2pair/preample/power/power.kicad_pcb

## KiCad design power/power.kicad_pcb (2019-06-02)

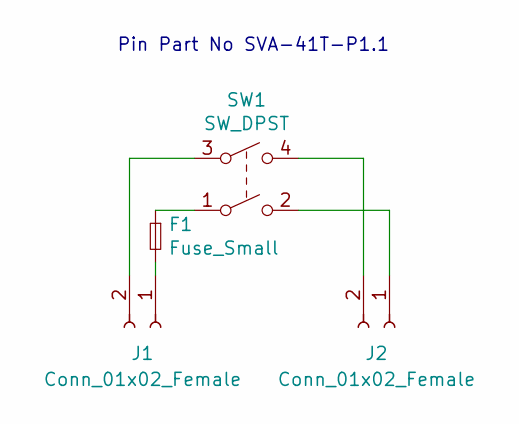
[picture p1: schematic power.sch]

Parts:
F1: Fuse_Small; Keystone 4628 Fuse Holder
J1, J2: Conn_01x02_Female; B2P3-VH
SW1: SW_DPST; E-Switch_P227EE1CXC

Connections:
unnamed: F1.1, SW1.1
unnamed: F1.2, J1.1
unnamed: J1.2, SW1.3
unnamed: J2.1, SW1.2
unnamed: J2.2, SW1.4

Notes on the sheet:
Pin Part No SVA-41T-P1.1

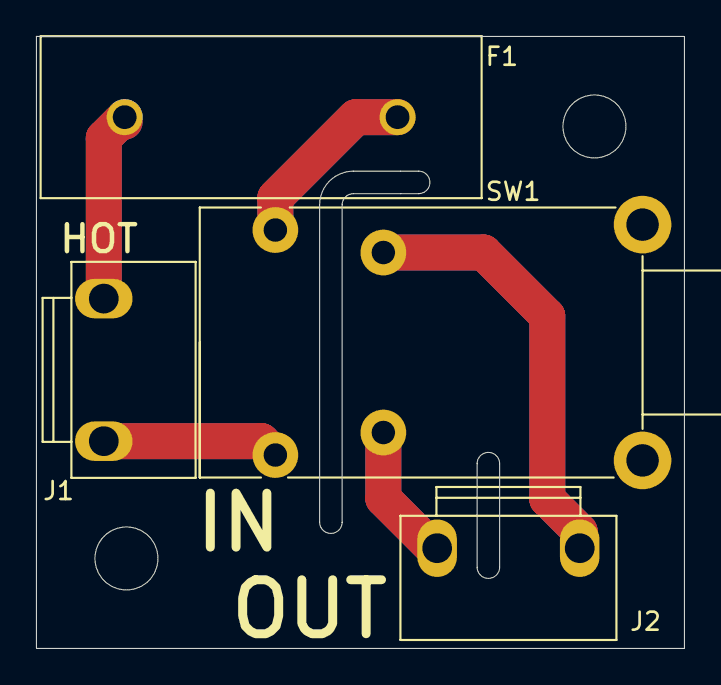
[picture p2: board power.kicad_pcb from above]

Board: 2 copper layers, 36.0 x 34.0 mm, 4 parts (0 on the bottom side), 5 nets.
