2pair/preample/preample/preample.kicad_pcb

## KiCad design preample/preample.kicad_pcb (2019-06-02)

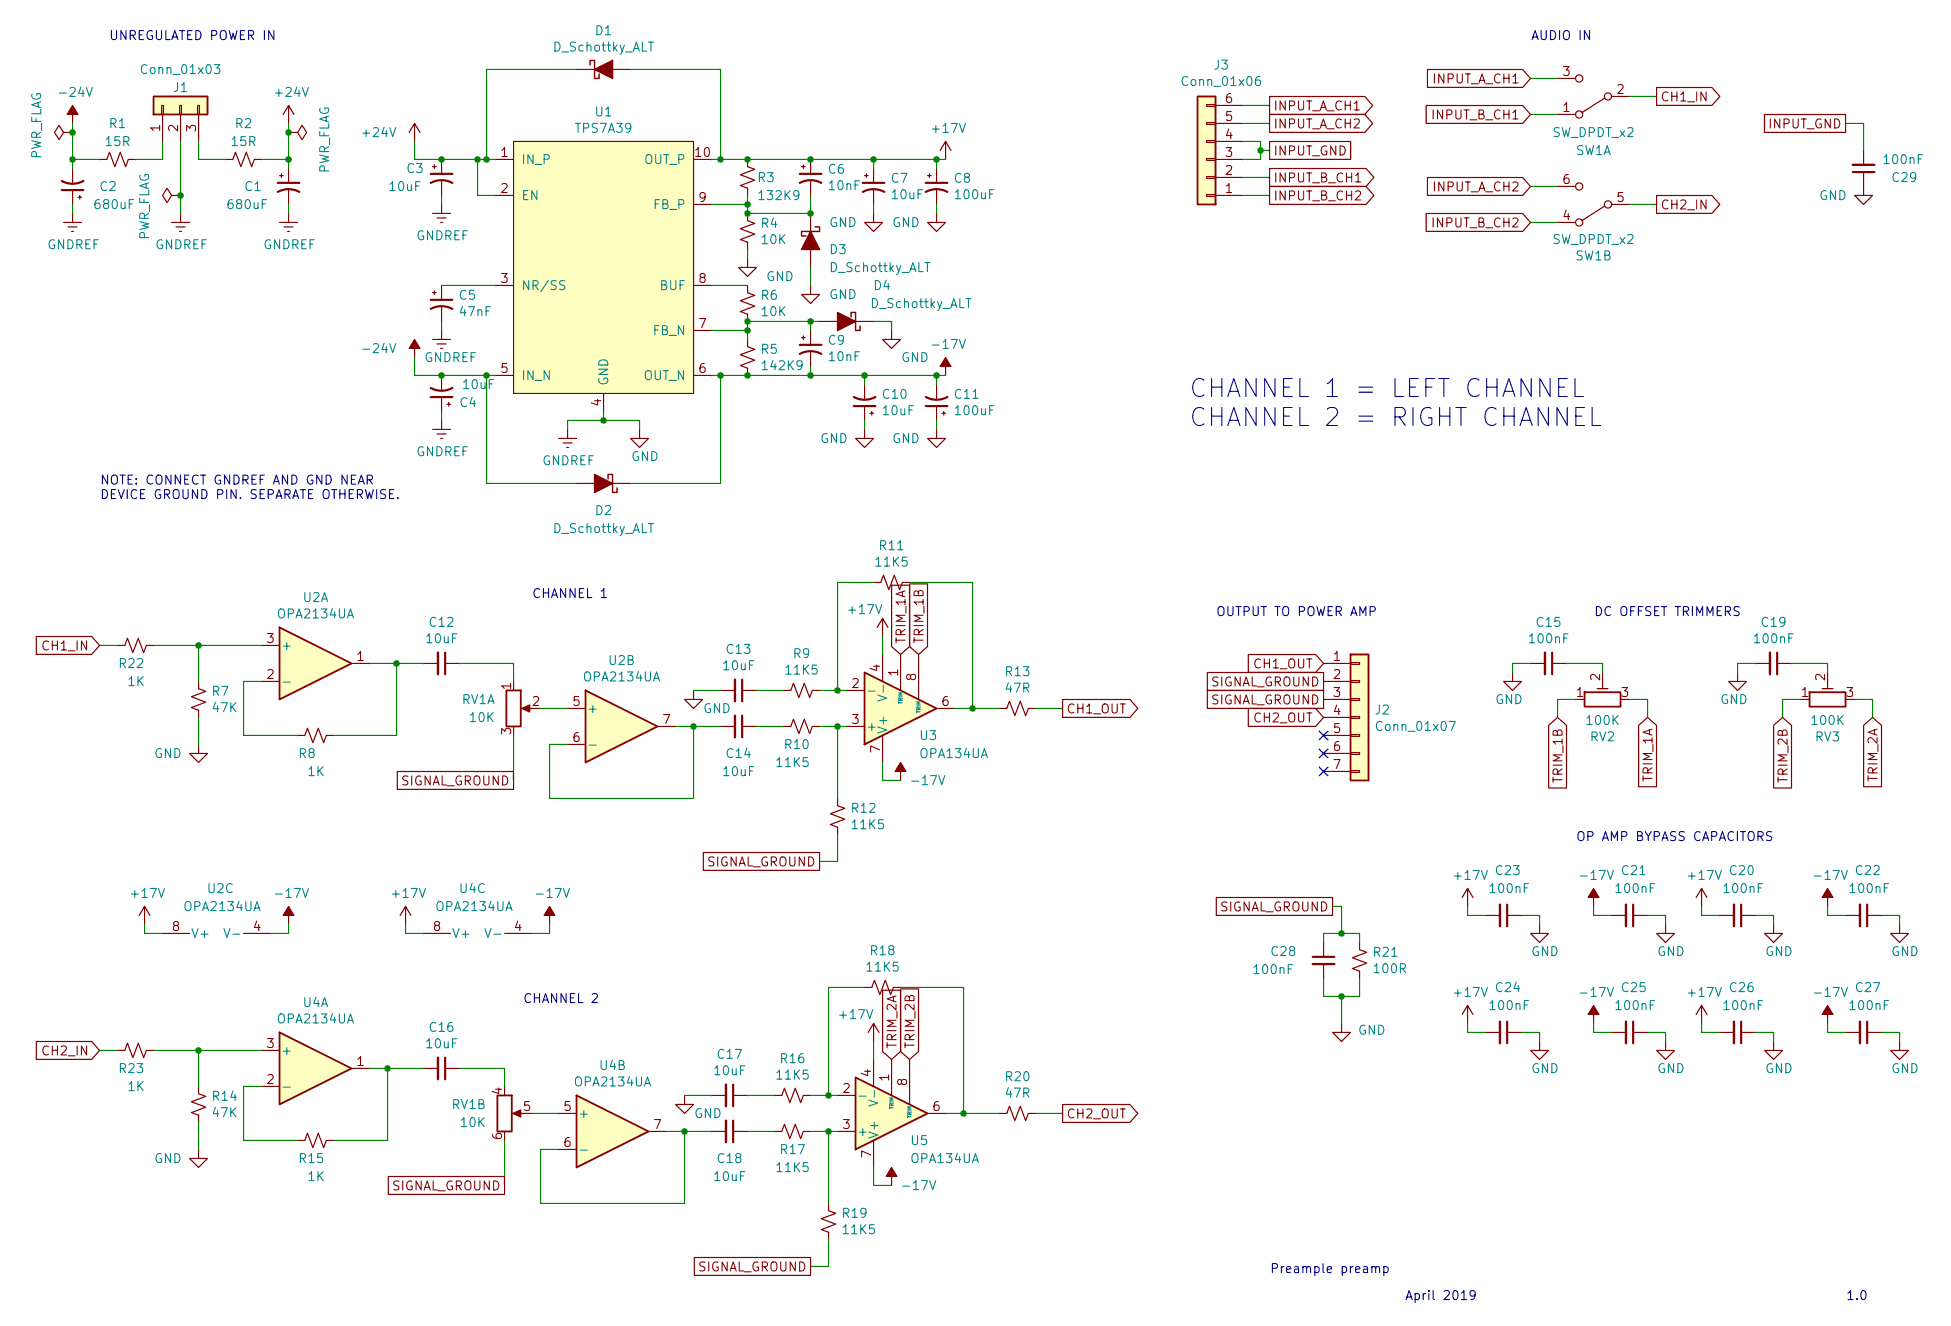
[picture p3: schematic preample.sch]

Parts:
C1, C2: 680uF; EEV-FK1H681M; Part No EEV-FK1H681M
C3, C4, C7, C10: 10uF; C_1206_3216Metric; Part No CL31B106KBHNNNE
C5: 47nF; C_0402_1005Metric; Part No GRM155R71E473KA88D
C6, C9: 10nF; C_0402_1005Metric; Part No CL05B103KB5NNNC
C8, C11: 100uF; PCR1E101MCL1GS; Part No PCR1E101MCL1GS
C12, C13, C14, C16, C17, C18: 10uF; MKS2B051001N00JSSD; Part No MKS2B051001N00JSSD
C15, C19, C20, C21, C22, C23, C24, C25, C26, C27: 100nF; C_0603_1608Metric; Part No CL10B104KB8NNNC
C28, C29: 100nF; SMDTD03100TA00KQ00; Part No SMDTD03100TA00KQ00
D1, D2, D3, D4: D_Schottky_ALT; D_SOD-323F; Part No RB751V-40WS RRG
J1: Conn_01x03; JST_PH_B3B-PH-K_1x03_P2.00mm_Vertical; Part No B3B-PH-K-S(LF)(SN)
J2: Conn_01x07; JST_PH_B7B-PH-K_1x07_P2.00mm_Vertical; Part No B7B-PH-K-S(LF)(SN)
J3: Conn_01x06; JST_PH_B6B-PH-K_1x06_P2.00mm_Vertical; Part No B6B-PH-K-S(LF)(SN)
R1, R2: 15R; R_2512_6332Metric; Part No RPC2512JT15R0
R3: 132K9; R_0402_1005Metric; Part No ERJ-2RKF1333X
R4, R6: 10K; R_0402_1005Metric; Part No ERJ-2RKF1002X
R5: 142K9; R_0402_1005Metric; Part No ERJ-2RKF1433X
R7, R14: 47K; R_0805_2012Metric; Part No ERA-6AEB473V
R8, R15, R22, R23: 1K; R_0805_2012Metric; Part No ERA-6AEB102V
R9, R10, R11, R12, R16, R17, R18, R19: 11K5; R_0805_2012Metric; Part No ERA-6AEB1152V
R13, R20: 47R; R_0805_2012Metric; Part No ERA-6AEB470V
R21: 100R; R_0805_2012Metric; Part No ERA-6AEB101V
RV1: 10K; RK271 10KAX2
RV2, RV3: 100K; 22AR100KLFTR; Part No 22AR100KLFTR
SW1: SW_DPDT_x2; PBH2UEENAGX
U1: TPS7A39
U2, U4: OPA2134UA; SOIC-8_3.9x4.9mm_P1.27mm
U3, U5: OPA134UA; SOIC-8_3.9x4.9mm_P1.27mm

Connections:
+15V: C6.1, C7.1, C8.1, C20.2, C23.2, C24.2, C26.2, D1.2 (A), R3.1, U1.10 (OUT_P), U2.8 (V+), U3.4 (V-), U4.8 (V+), U5.4 (V-)
+24V: C1.1, C3.1, D1.1 (K), R2.2, U1.1 (IN_P), U1.2 (EN)
-15V: C9.2, C10.2, C11.2, C21.2, C22.2, C25.2, C27.2, D2.1 (K), R5.2, U1.6 (OUT_N), U2.4 (V-), U3.7 (V+), U4.4 (V-), U5.7 (V+)
-24V: C2.2, C4.2, D2.2 (A), R1.1, U1.5 (IN_N)
CH1_IN: R22.1, SW1.2 (B)
CH1_OUT: J2.1, R13.2
CH2_IN: R23.1, SW1.5 (B)
CH2_OUT: J2.4, R20.1
GND: C1.2, C2.1, C3.2, C4.1, C5.2, C7.2, C8.2, C10.1, C11.1, C13.2, C15.2, C17.2, C19.2, C20.1, C21.1, C22.1, C23.1, C24.1, C25.1, C26.1, C27.1, C28.2, C29.1, D3.2 (A), D4.1 (K), J1.2, R4.2, R7.1, R14.1, R21.2, U1.4 (GND)
INPUT_A_CH1: J3.6, SW1.3 (C)
INPUT_A_CH2: J3.5, SW1.6 (C)
INPUT_B_CH1: J3.2, SW1.1 (A)
INPUT_B_CH2: J3.1, SW1.4 (A)
INPUT_GND: C29.2, J3.3, J3.4
unnamed: C5.1, U1.3 (NR/SS)
unnamed: C6.2, D3.1 (K), R3.2, R4.1, U1.9 (FB_P)
unnamed: C9.1, D4.2 (A), R5.1, R6.2, U1.7 (FB_N)
unnamed: C12.1, RV1.1
unnamed: C12.2, R8.2, U2.1
unnamed: C13.1, R9.2
unnamed: C14.1, R10.1
unnamed: C14.2, U2.6 (-), U2.7
unnamed: C15.1, RV2.2
unnamed: C16.1, RV1.4
unnamed: C16.2, R15.2, U4.1
unnamed: C17.1, R16.2
unnamed: C18.1, R17.1
unnamed: C18.2, U4.6 (-), U4.7
unnamed: C19.1, RV3.2
unnamed: J1.1, R1.2
unnamed: J1.3, R2.1
unnamed: R6.1, U1.8 (BUF)
unnamed: R8.1, U2.2 (-)
unnamed: R10.2, R12.2, U3.3 (+)
unnamed: R11.1, R13.1, U3.6
unnamed: R9.1, R11.2, U3.2 (-)
unnamed: R14.2, R23.2, U4.3 (+)
unnamed: R15.1, U4.2 (-)
unnamed: R16.1, R18.2, U5.2 (-)
unnamed: R17.2, R19.2, U5.3 (+)
unnamed: R18.1, R20.2, U5.6
unnamed: R7.2, R22.2, U2.3 (+)
unnamed: RV1.2, U2.5 (+)
unnamed: RV1.5, U4.5 (+)
SIGNAL_GROUND: C28.1, J2.2, J2.3, R12.1, R19.1, R21.1, RV1.3, RV1.6
TRIM_1A: RV2.3, U3.1 (TRIM)
TRIM_1B: RV2.1, U3.8 (TRIM)
TRIM_2A: RV3.3, U5.1 (TRIM)
TRIM_2B: RV3.1, U5.8 (TRIM)

Notes on the sheet:
DC OFFSET TRIMMERS
UNREGULATED POWER IN
Preample preamp
April 2019
1.0
OP AMP BYPASS CAPACITORS
OUTPUT TO POWER AMP
NOTE: CONNECT GNDREF AND GND NEAR DEVICE GROUND PIN. SEPARATE OTHERWISE.
CHANNEL 1
CHANNEL 2
AUDIO IN
CHANNEL 1 = LEFT CHANNEL CHANNEL 2 = RIGHT CHANNEL

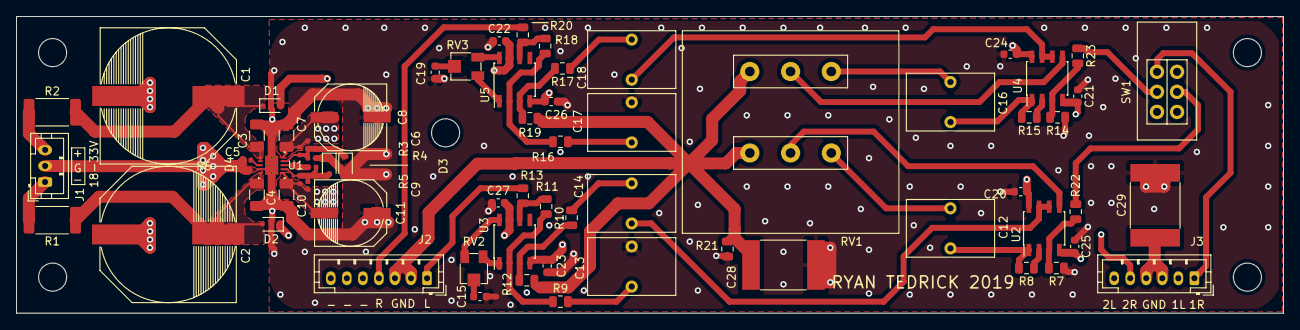
[picture p4: board preample.kicad_pcb from above]

Board: 4 copper layers, 158.0 x 37.0 mm, 68 parts (0 on the bottom side), 49 nets.
