2pair/preample/(commit log)

2019-04-23 Basics of schematic mostly in place
    [preample.kicad_pcb, preample.sch]
2019-04-29 changed op amps. changed rail voltages. hooked up bypass caps for op amps. additional passives for noise reduction in op amp circuits.
    separated the signal grounds. Need to do more research on if that is a
    normal thing. Added rca inputs, need to investigate if a simple switch
    is enough or if analog mux circuits are needed.
    [preample.sch]
2019-05-01 added layout sketch. working on grounds. playing with connectors.
    [preample.sch]
2019-05-07 Added switching circuit. Added power supply footprints. Started power supply layout.
    [preample.kicad_pcb, preample.sch]
2019-05-08 swapped 10uF psu caps for smaller ceramics. assigned footprints to many passives. more pcb layout.
    [preample.kicad_pcb, preample.sch]
2019-05-11 all footprints made except connectors. all signal traced laid.
    [preample.kicad_pcb, preample.sch]
2019-05-12 reorganized PCB to fit target chassis
    [preample.kicad_pcb]
2019-05-14 Fixed cap issue in schematic. finished pcb layout
    [preample.kicad_pcb, preample.sch]
2019-05-26 Changes resistors for opamps to 0805s. Chose more realistic power resistors. rerouted for new components.
    [preample.kicad_pcb, preample.sch]
2019-05-27 Added simulation. Added current path for negative feed forward cap. Chose resistors for amplifier circuits.
    [preample.kicad_pcb, preample.sch]
2019-05-28 Drawing for back faceplate. Added F\fuse
2019-05-31 Added breakout board for power switch
    [power.kicad_pcb, power.sch]
2019-06-02 finished power breakout board. added input breakout board
    [input.kicad_pcb, input.sch, power.kicad_pcb]
2019-06-02 Reorganized repo. Added gerbers.
    [input-B_Cu.gbr, input-B_Mask.gbr, input-B_Paste.gbr, input-B_SilkS.gbr, input-Edge_Cuts.gbr, input-F_Cu.gbr, input-F_Mask.gbr, input-F_Paste.gbr]
